vanekroman/MEIT/README.md

# Modular system for Electrical Impedance Tomography

Hardware, Firmware and Software development.
