vanekroman/MEIT/Hardware/MEIT_diagram.pdf

# Power supply module

# Main controller module

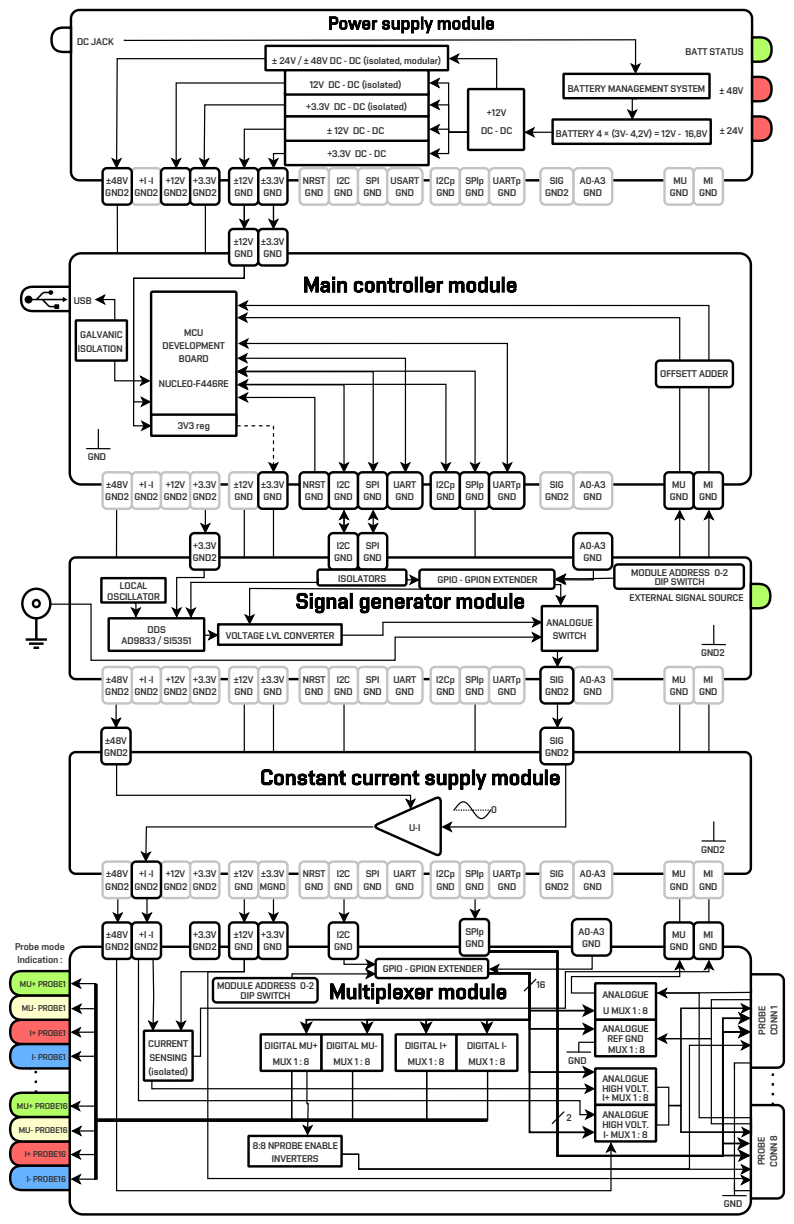
[picture p1: page 1]
I+ PROBE16; I- PROBE16; MU- PROBE16; I+ PROBE1; I- PROBE1; MU- PROBE1; MU+ PROBE1; PROBE; CONN 8; CONN 1; BATTERY 4 × (3V- 4,2V) = 12V - 16,8V; BATTERY MANAGEMENT SYSTEM; BATT STATUS; DC JACK; MCU DEVELOPMENT BOARD; NUCLEO-F446RE; Signal generator module; DDS AD9833 / SI5351; LOCAL OSCILLATOR; GND; ANALOGUE SWITCH; Multiplexer module; ANALOGUE; U MUX 1 : 8; ANALOGUE REF GND MUX 1 : 8; ANALOGUE HIGH VOLT. I+ MUX 1 : 8; ANALOGUE HIGH VOLT. I- MUX 1 : 8; CURRENT SENSING (isolated); ±12V GND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

± 24V / ± 48V DC - DC (isolated, modular)

12V DC - DC (isolated)

+3.3V DC - DC (isolated)

DIP SWITCH
EXTERNAL SIGNAL SOURCE

GPIO - GPION EXTENDER

VOLTAGE LVL CONVERTER

Constant current supply module
