vanekroman/MEIT/Hardware/MEIT_main/MEIT_probe/MEIT_probe.pdf

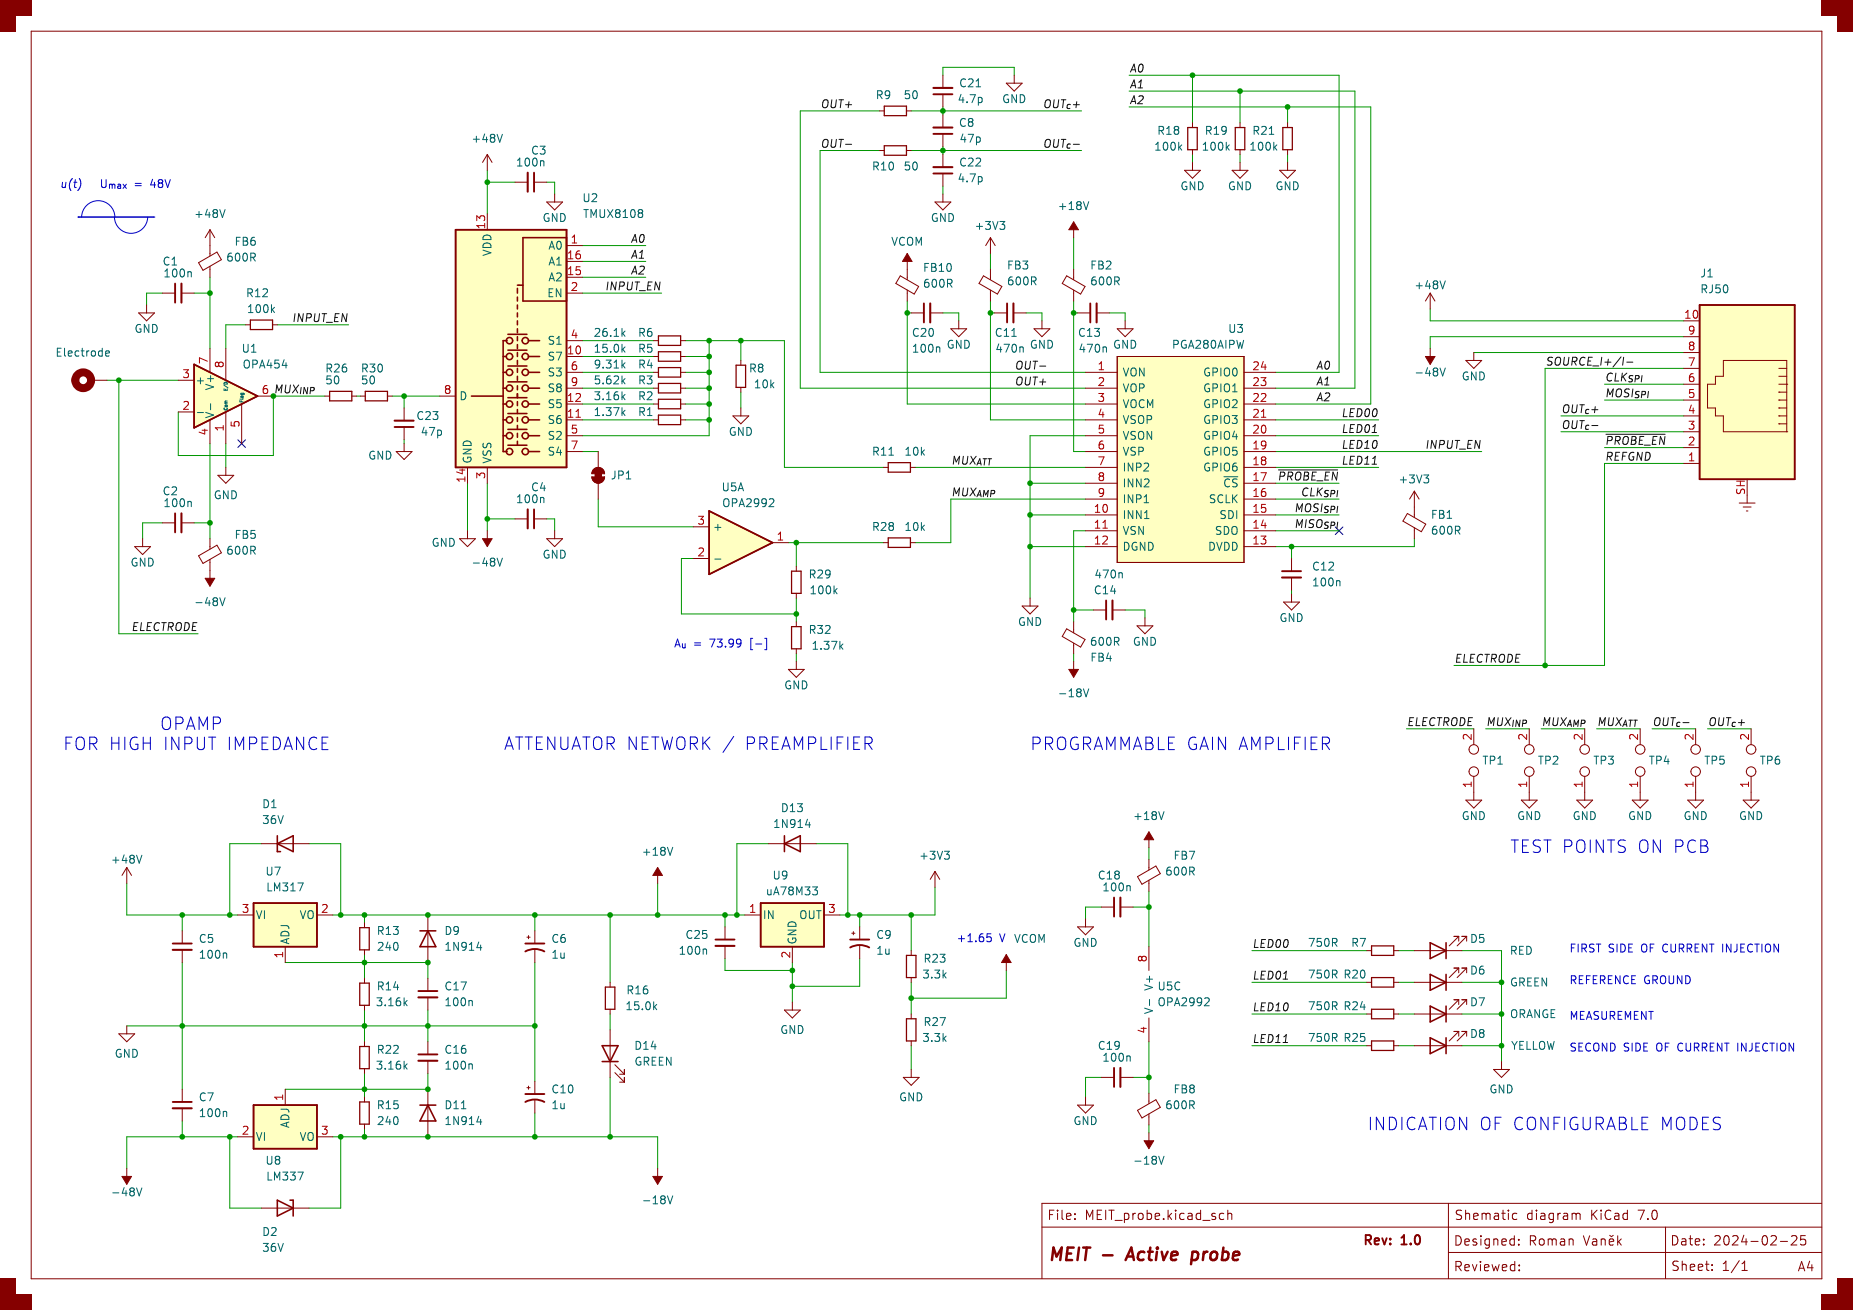
[picture p2: page 1]
