vanekroman/MEIT/Hardware/MEIT_main/MEIT_probe/MEIT_probe.kicad_pcb

## KiCad design Hardware/MEIT_main/MEIT_probe/MEIT_probe.kicad_pcb (2024-10-14)

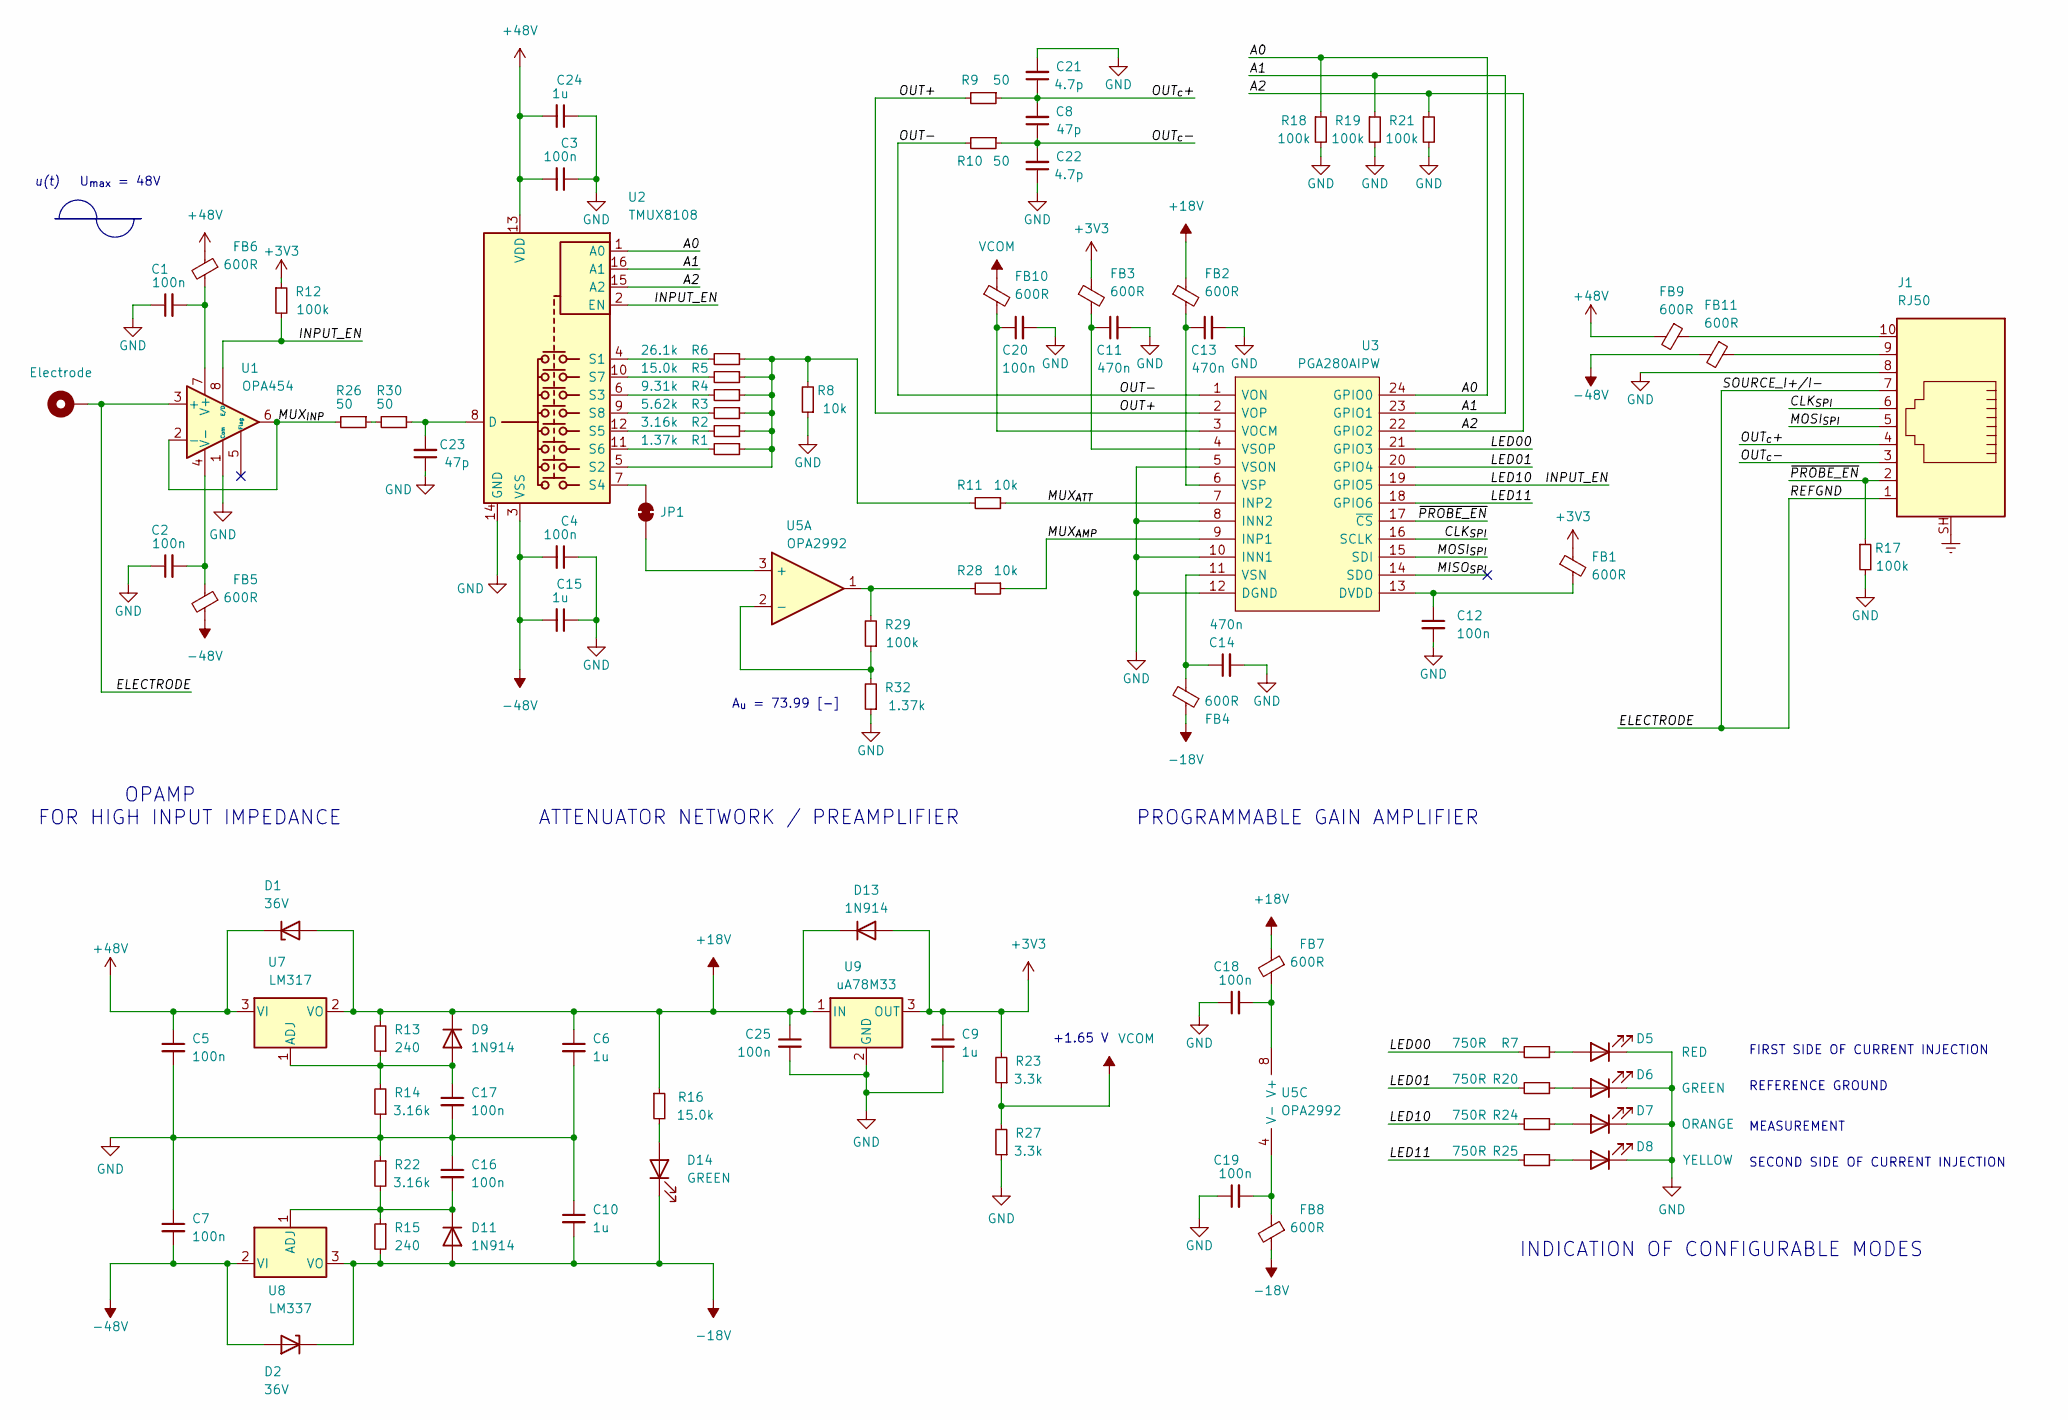
[picture p3: schematic MEIT_probe.kicad_sch, MEIT - Active probe]

Parts:
C1, C2, C3, C4, C5, C7, C12, C16, C17, C18, C19, C20, C25: 100n; C_0805_2012Metric_Pad1.18x1.45mm_HandSolder; Part Number 100n
C6, C9, C10, C15, C24: 1u; C_0805_2012Metric_Pad1.18x1.45mm_HandSolder; Part Number 1u
C8, C23: 47p; C_0805_2012Metric_Pad1.18x1.45mm_HandSolder; Part Number 100n
C11, C13, C14: 470n; C_0805_2012Metric_Pad1.18x1.45mm_HandSolder; Part Number 470n
C21, C22: 4.7p; C_0805_2012Metric_Pad1.18x1.45mm_HandSolder; Part Number 100n
D1, D2: 36V; D_SMB_403A; Part Number 36V
D5: RED; LED_0603_1608Metric_Pad1.05x0.95mm_HandSolder; Part Number CSL1901UW1
D6, D14: GREEN; LED_0603_1608Metric_Pad1.05x0.95mm_HandSolder; Part Number CSL1901MW1
D7: ORANGE; LED_0603_1608Metric_Pad1.05x0.95mm_HandSolder; Part Number CSL1901DW1
D8: YELLOW; LED_0603_1608Metric_Pad1.05x0.95mm_HandSolder; Part Number CSL1901YW1
D9, D11, D13: 1N914; D_SOD-523F; Part Number 1N914WT
FB1, FB2, FB3, FB4, FB5, FB6, FB7, FB8, FB9, FB10, FB11: 600R; LED_0603_1608Metric_Pad1.05x0.95mm_HandSolder; Part Number FBMH1608HM601
H1: Electrode
J1: RJ50; RJ50_117345801; Part Number RJE051AA1310
JP1: SEL_CAP; SolderJumper-2_P1.3mm_Bridged_Pad1.0x1.5mm
R1: 1.37k; R_0805_2012Metric_Pad1.20x1.40mm_HandSolder; Part Number 1.37k
R2, R14, R22: 3.16k; R_0805_2012Metric_Pad1.20x1.40mm_HandSolder; Part Number 3.16k
R3: 5.62k; R_0805_2012Metric_Pad1.20x1.40mm_HandSolder; Part Number 5.62k
R4: 9.31k; R_0805_2012Metric_Pad1.20x1.40mm_HandSolder; Part Number 9.31k
R5, R16: 15.0k; R_0805_2012Metric_Pad1.20x1.40mm_HandSolder; Part Number 15.0k
R6: 26.1k; R_0805_2012Metric_Pad1.20x1.40mm_HandSolder; Part Number 26.1k
R7, R20, R24, R25: 750R; R_0805_2012Metric_Pad1.20x1.40mm_HandSolder; Part Number 750R
R8: 10k; R_0805_2012Metric_Pad1.20x1.40mm_HandSolder; Part Number 10k
R9, R10, R26, R30: 50; R_0805_2012Metric_Pad1.20x1.40mm_HandSolder; Part Number 100k
R11, R28: 10k; R_0805_2012Metric_Pad1.20x1.40mm_HandSolder; Part Number 3.16k
R12, R29: 100k; R_0805_2012Metric_Pad1.20x1.40mm_HandSolder; Part Number 240
R13, R15: 240; R_0805_2012Metric_Pad1.20x1.40mm_HandSolder; Part Number 240
R17, R18, R19, R21: 100k; R_0805_2012Metric_Pad1.20x1.40mm_HandSolder; Part Number 100k
R23, R27: 3.3k; R_0805_2012Metric_Pad1.20x1.40mm_HandSolder; Part Number 3.3k
R32: 1.37k; R_0805_2012Metric_Pad1.20x1.40mm_HandSolder; Part Number 3.16k
U1: OPA454; SOIC-8-1EP_3.9x4.9mm_P1.27mm_EP2.514x3.2mm; Part Number OPA454AIDDA
U2: TMUX8108; TSSOP-16_4.4x5mm_P0.65mm; Part Number TMUX8108PWR
U3: PGA280AIPW; SOP65P640X120-24N; Manufacturer_Part_Number PGA280AIPW; Mouser Part Number 595-PGA280AIPW
U5: OPA2992; SOIC-8_3.9x4.9mm_P1.27mm; MPN OPA2992IDR
U7: LM317; SOT-223-3_TabPin2; MPN LM317MDCYR
U8: LM337; SOT-223-3_TabPin2; MPN LM337IMP/NOPB
U9: uA78M33; SOT-223-3_TabPin2; MPN UA78M33QDCYRG4Q1

Connections:
+3V3: C9.1, D13.2 (A), FB1.1, FB3.1, R12.1, R23.2, U9.3 (OUT)
+18V: C6.1, C25.1, D1.2 (A), D9.1 (K), D13.1 (K), FB2.1, FB7.1, R13.2, R16.1, U7.2 (VO), U9.1 (IN)
+48V: C3.2, C5.1, C24.2, D1.1 (K), FB6.1, FB9.1, FB9.2, J1.10, U2.13 (VDD), U7.3 (VI)
-18V: C10.2, D2.1 (K), D11.2 (A), D14.1 (K), FB4.1, FB8.2, R15.2, U8.3 (VO)
-48V: C4.2, C7.2, C15.2, D2.2 (A), FB5.2, FB11.1, FB11.2, J1.9, U2.3 (VSS), U8.2 (VI)
/A0: R18.1, U2.1 (A0), U3.24 (GPIO0)
/A1: R19.1, U2.16 (A1), U3.23 (GPIO1)
/A2: R21.1, U2.15 (A2), U3.22 (GPIO2)
/CLK_{SPI}: J1.6, U3.16 (SCLK); also elsewhere on the board
/ELECTRODE: H1.1, J1.1, J1.7, U1.3 (+); also elsewhere on the board
/INPUT_EN: R12.2, R24.2, U1.8 (E/D), U2.2 (EN), U3.19 (GPIO5)
/LED00: R7.2, U3.21 (GPIO3)
/LED01: R20.2, U3.20 (GPIO4)
/LED11: R25.2, U3.18 (GPIO6)
/MISO_{SPI}: U3.14 (SDO)
/MOSI_{SPI}: J1.5, U3.15 (SDI); also elsewhere on the board
/MUX_{AMP}: R28.1, U3.9 (INP1)
/MUX_{ATT}: R11.1, U3.7 (INP2)
/MUX_{INP}: R26.2, U1.2 (-), U1.6
/OUT+: R9.2, U3.2 (VOP)
/OUT-: R10.2, U3.1 (VON)
/OUT_{c}+: C8.2, C21.1, J1.4, R9.1
/OUT_{c}-: C8.1, C22.2, J1.3, R10.1
/~PROBE_EN: J1.2, R17.1, U3.17 (~CS)
Earth: J1.SH
GND: C1.1, C2.1, C3.1, C4.1, C5.2, C6.2, C7.1, C9.2, C10.1, C11.2, C12.2, C13.2, C14.2, C15.1, C16.1, C17.2, C18.1, C19.1, C20.2, C21.2, C22.1, C23.1, C24.1, C25.2, D5.1 (K), D6.1 (K), D7.1 (K), D8.1 (K), J1.8, R8.1, R14.1, R17.2, R18.2, R19.2, R21.2, R22.1, R27.1, R32.1, U1.1 (Com), U2.14 (GND), U3.5 (VSON), U3.8 (INN2), U3.10 (INN1), U3.12 (DGND), U9.2 (GND)
unnamed: D5.2 (A), R7.1
unnamed: D6.2 (A), R20.1
unnamed: D7.2 (A), R24.1
unnamed: D8.2 (A), R25.1
unnamed: C17.1, D9.2 (A), R13.1, R14.2, U7.1 (ADJ)
unnamed: C16.2, D11.1 (K), R15.1, R22.2, U8.1 (ADJ)
unnamed: D14.2 (A), R16.2
unnamed: JP1.1 (A), U2.7 (S4)
unnamed: JP1.2 (B), U5.3 (+)
unnamed: R26.1, R30.2
unnamed: R28.2, R29.2, U5.1
unnamed: C1.2, FB6.2, U1.7 (V+)
unnamed: C2.2, FB5.1, U1.4 (V-)
unnamed: C23.2, R30.1, U2.8 (D)
unnamed: R6.2, U2.4 (S1)
unnamed: R1.1, R2.1, R3.1, R4.1, R5.1, R6.1, R8.2, R11.2, U2.5 (S2)
unnamed: R4.2, U2.6 (S3)
unnamed: R2.2, U2.12 (S5)
unnamed: R1.2, U2.11 (S6)
unnamed: R5.2, U2.10 (S7)
unnamed: R3.2, U2.9 (S8)
unnamed: C12.1, FB1.2, U3.13 (DVDD)
unnamed: C20.1, FB10.2, U3.3 (VOCM)
unnamed: C14.1, FB4.2, U3.11 (VSN)
unnamed: C11.1, FB3.2, U3.4 (VSOP)
unnamed: C13.1, FB2.2, U3.6 (VSP)
unnamed: R29.1, R32.2, U5.2 (-)
unnamed: C18.2, FB7.2, U5.8 (V+)
unnamed: C19.2, FB8.1, U5.4 (V-)
VCOM: FB10.1, R23.1, R27.2

Notes on the sheet:
A_{u} = 73.99 [-]
FIRST SIDE OF CURRENT INJECTION
U_{max} = 48V
+1.65 V
OPAMP FOR HIGH INPUT IMPEDANCE
MEASUREMENT
REFERENCE GROUND
INDICATION OF CONFIGURABLE MODES
ATTENUATOR NETWORK / PREAMPLIFIER
SECOND SIDE OF CURRENT INJECTION
PROGRAMMABLE GAIN AMPLIFIER
u(t)

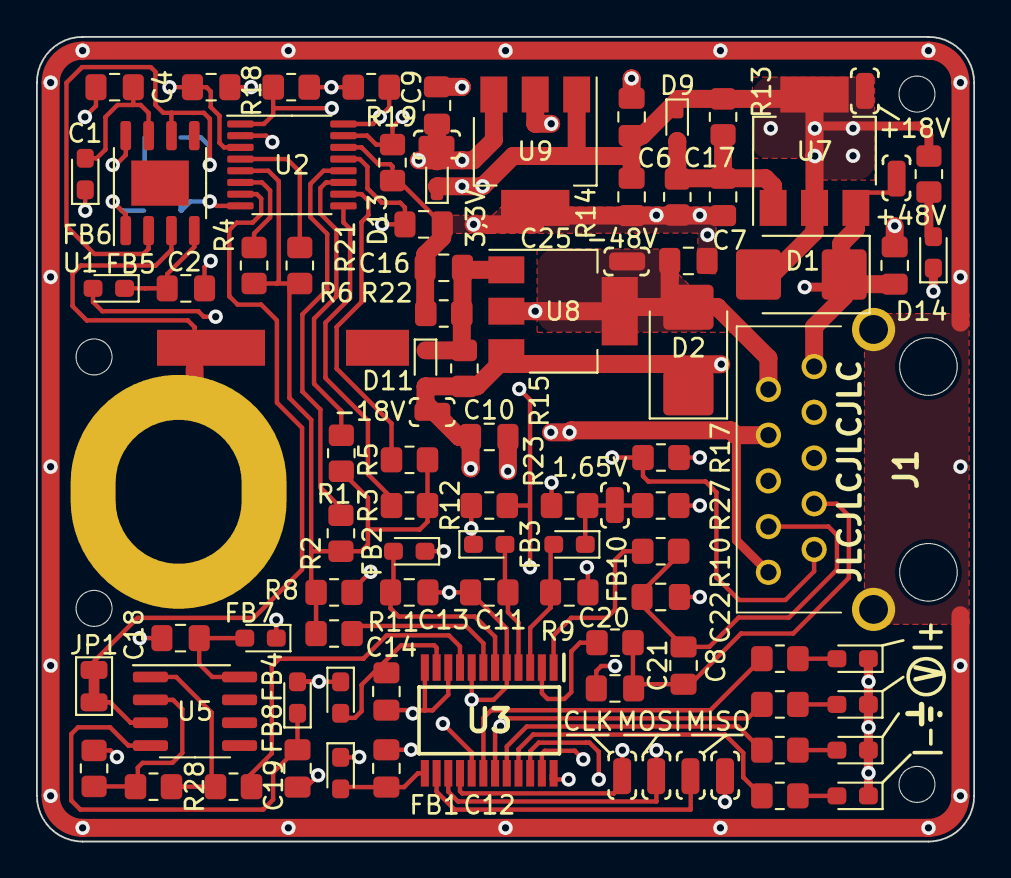
[picture p4: board MEIT_probe.kicad_pcb from above]

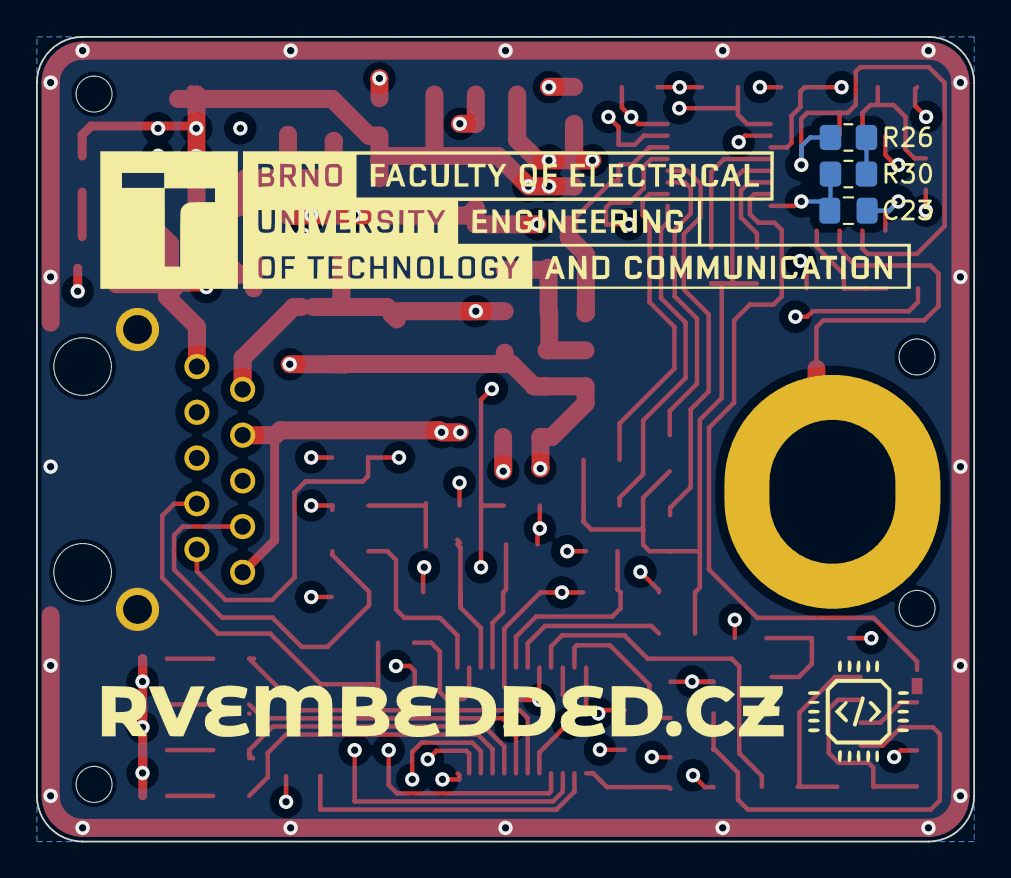
[picture p5: board MEIT_probe.kicad_pcb from below]

Board: 4 copper layers, 52.1 x 44.7 mm, 87 parts (3 on the bottom side), 54 nets.

Other parts of the board:
CLK: SolderWirePad_1x01_SMD_1x2mm
J**: 2060451998404
MISO: SolderWirePad_1x01_SMD_1x2mm
MISO#2: SolderWirePad_1x01_SMD_1x2mm
MOSI: SolderWirePad_1x01_SMD_1x2mm

Their connections:
/CLK_{SPI}: CLK.1; also elsewhere on the board
/ELECTRODE: J**.1; also elsewhere on the board
/MOSI_{SPI}: MOSI.1; also elsewhere on the board
