vanekroman/MEIT/Hardware/SIM/MEIT_probe_filter.kicad_sch

## KiCad design Hardware/SIM/MEIT_probe_filter.kicad_sch (2024-10-14)

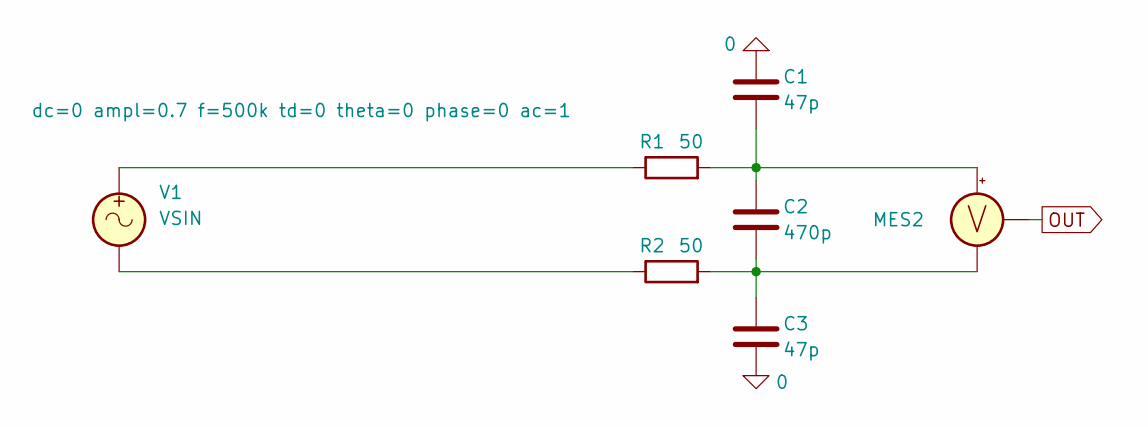
[picture p6: schematic MEIT_probe_filter.kicad_sch]

Parts:
C1, C3: 47p
C2: 470p
MES2: VOLTMETER_DIFF
R1, R2: 50
V1: VSIN

Connections:
0: C1.2, C3.2
unnamed: C1.1, C2.1, MES2.1 (+), R1.2
unnamed: C2.2, C3.1, MES2.2 (-), R2.2
unnamed: R1.1, V1.1
unnamed: R2.1, V1.2
OUT: MES2.3 (out)
