vanekroman/MEIT/Hardware/SIM/MEIT_probe_pwrsim.kicad_sch

## KiCad design Hardware/SIM/MEIT_probe_pwrsim.kicad_sch (2024-10-14)

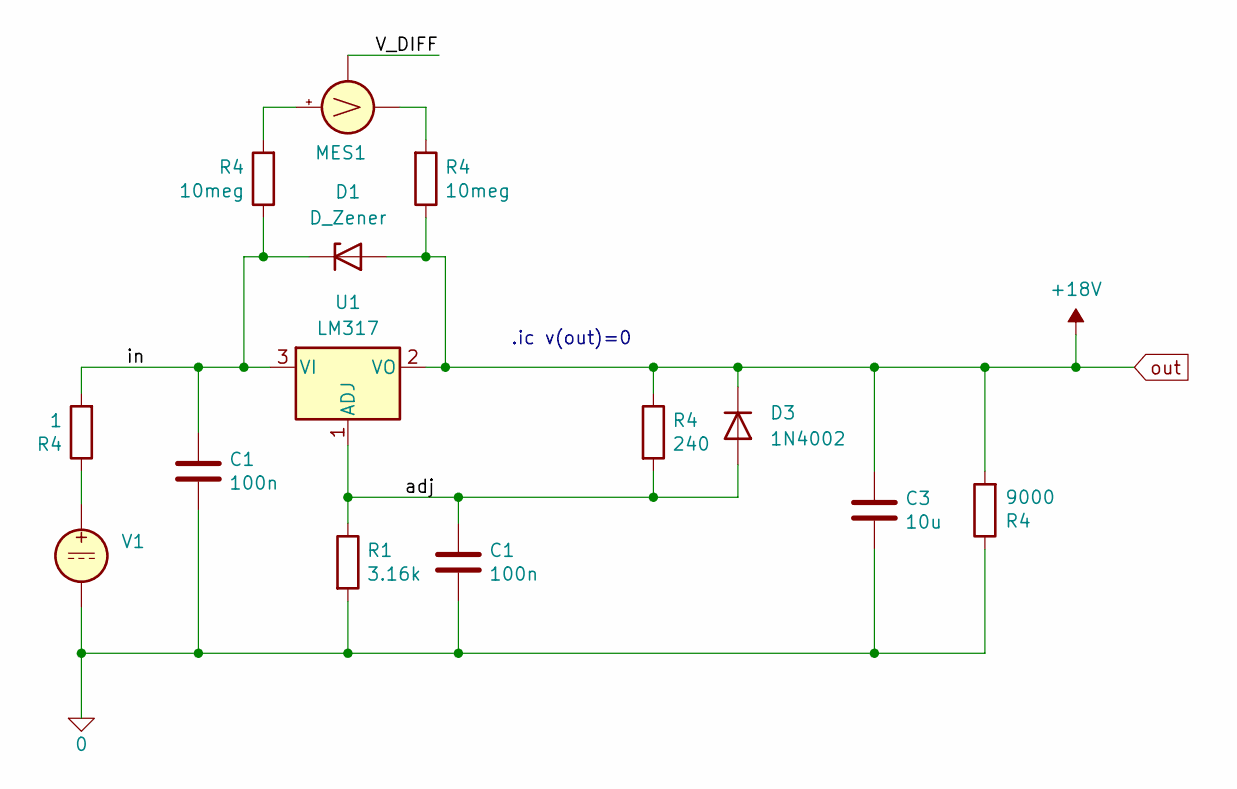
[picture p7: schematic MEIT_probe_pwrsim.kicad_sch]

Parts:
C1: 100n
C3: 10u
D1: D_Zener
D3: 1N4002; D_DO-41_SOD81_P10.16mm_Horizontal
MES1: VOLTMETER_DIFF
R1: 3.16k
R4: 10meg
U1: LM317; TO-220-3_Vertical
V1: (no value)

Connections:
0: C1.2, C3.2, R1.2, R4.1, V1.2
+18V: C3.1, D1.2 (A), D3.1 (K), R4.1, R4.2, U1.2 (VO)
unnamed: MES1.1 (+), R4.2
unnamed: MES1.2 (-), R4.2
unnamed: R4.1, V1.1
V_DIFF: MES1.3 (out)
adj: C1.1, D3.2 (A), R1.1, R4.2, U1.1 (ADJ)
in: C1.1, D1.1 (K), R4.1, R4.2, U1.3 (VI)

Notes on the sheet:
.ic v(out)=0
