vanekroman/MEIT/Firmware/meit-f302r8/meit-f302r8.ioc

Mcu.UserName=STM32F302R8Tx
PA0.Signal=ADC1_IN1
PA1.Signal=ADC1_IN2
PA13.GPIO_Label=TMS
PA13.Signal=SYS_JTMS-SWDIO
PA14.GPIO_Label=TCK
PA14.Signal=SYS_JTCK-SWCLK
PA2.GPIO_Label=USART_TX
PA2.Signal=USART2_TX
PA3.GPIO_Label=USART_RX
PA3.Signal=USART2_RX
PA7.GPIO_Label=SPIP_CS1
PA7.Signal=GPIO_Output
PB10.GPIO_Label=SPIP_CS2
PB10.Signal=GPIO_Output
PB13.GPIO_Label=LD2 [Green Led]
PB13.Signal=GPIO_Output
PB3.GPIO_Label=SWO
PB3.Signal=SYS_JTDO-TRACESWO
PC10.GPIO_Label=SPIP_SCK
PC10.Signal=SPI3_SCK
PC11.GPIO_Label=SPIP_MISO
PC11.Signal=SPI3_MISO
PC12.GPIO_Label=SPIP_MOSI
PC12.Signal=SPI3_MOSI
PC13.GPIO_Label=B1 [Blue PushButton]
PC13.Signal=GPXTI13
PC2.Signal=ADCx_IN8
PC3.Signal=ADCx_IN9
PF0-OSC_IN.Signal=RCC_OSC_IN
PF1-OSC_OUT.Signal=RCC_OSC_OUT
