vanekroman/MEIT/Firmware/meit-f302r8/Core/Inc/main.h

#define B1_Pin GPIO_PIN_13
#define B1_GPIO_Port GPIOC
#define USART_TX_Pin GPIO_PIN_2
#define USART_TX_GPIO_Port GPIOA
#define USART_RX_Pin GPIO_PIN_3
#define USART_RX_GPIO_Port GPIOA
#define SPIP_CS1_Pin GPIO_PIN_7
#define SPIP_CS1_GPIO_Port GPIOA
#define SPIP_CS2_Pin GPIO_PIN_10
#define SPIP_CS2_GPIO_Port GPIOB
#define LD2_Pin GPIO_PIN_13
#define LD2_GPIO_Port GPIOB
#define TMS_Pin GPIO_PIN_13
#define TMS_GPIO_Port GPIOA
#define TCK_Pin GPIO_PIN_14
#define TCK_GPIO_Port GPIOA
#define SPIP_SCK_Pin GPIO_PIN_10
#define SPIP_SCK_GPIO_Port GPIOC
#define SPIP_MISO_Pin GPIO_PIN_11
#define SPIP_MISO_GPIO_Port GPIOC
#define SPIP_MOSI_Pin GPIO_PIN_12
#define SPIP_MOSI_GPIO_Port GPIOC
#define SWO_Pin GPIO_PIN_3
#define SWO_GPIO_Port GPIOB
