vanekroman/MEIT/(commit log)

2024-10-14 Initial commit
    Firmware, Hardware and Software as it is on dspace.vut.cz
    [MEIT_interface.kicad_sch, MEIT_probe.kicad_pcb, MEIT_probe.kicad_sch, MEIT_probe_filter.kicad_sch, MEIT_probe_pwrsim.kicad_sch, MEIT_switch.kicad_pcb, MEIT_switch.kicad_sch]
2024-10-17 Drivers directory gitignore add
